maarten-pennings/6502/0intro/6502-4.png

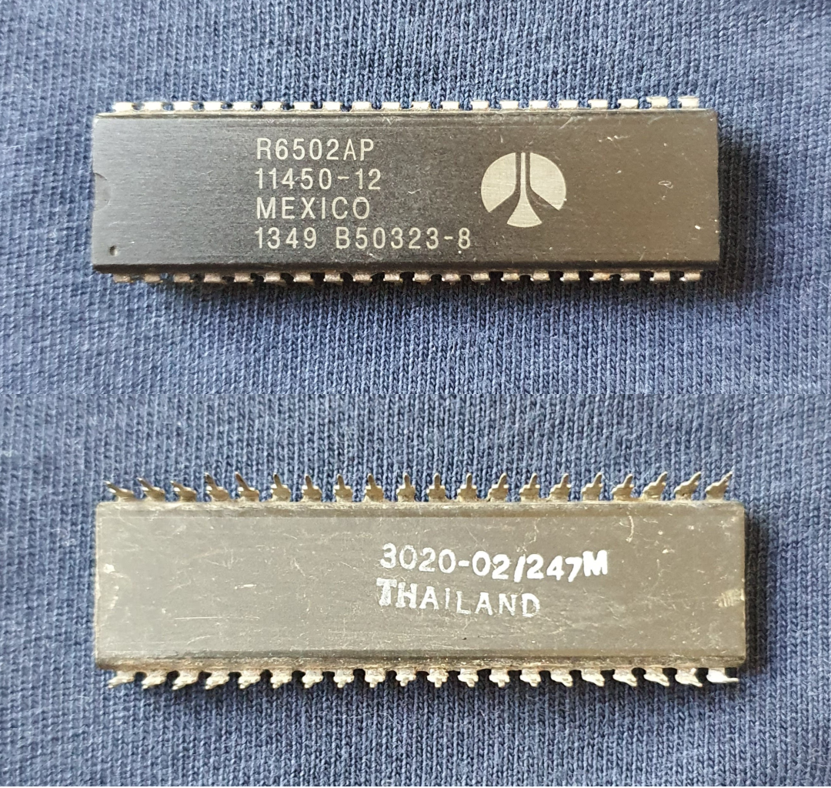
0intro/6502-4.png
