maarten-pennings/6502/1clock/unicode-chrome-windows-edit.png

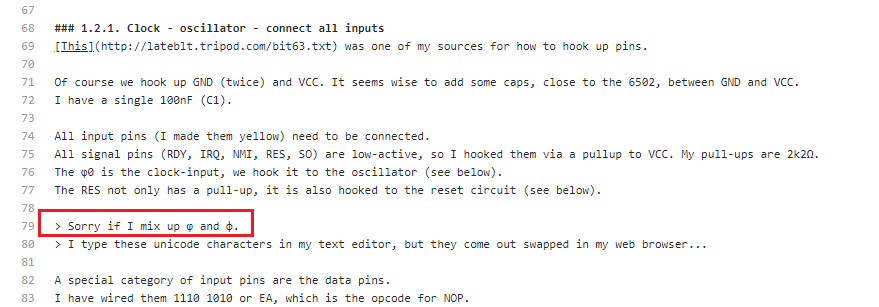
1clock/unicode-chrome-windows-edit.png
