maarten-pennings/6502/1clock/unicode-chrome-windows-view.png

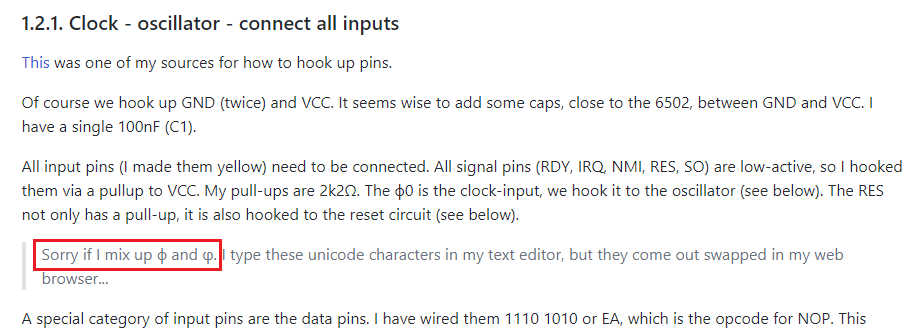
1clock/unicode-chrome-windows-view.png
