maarten-pennings/6502/2emulation/2560shield.pdf

Address bus | R65C02 (slave)

## Output signals

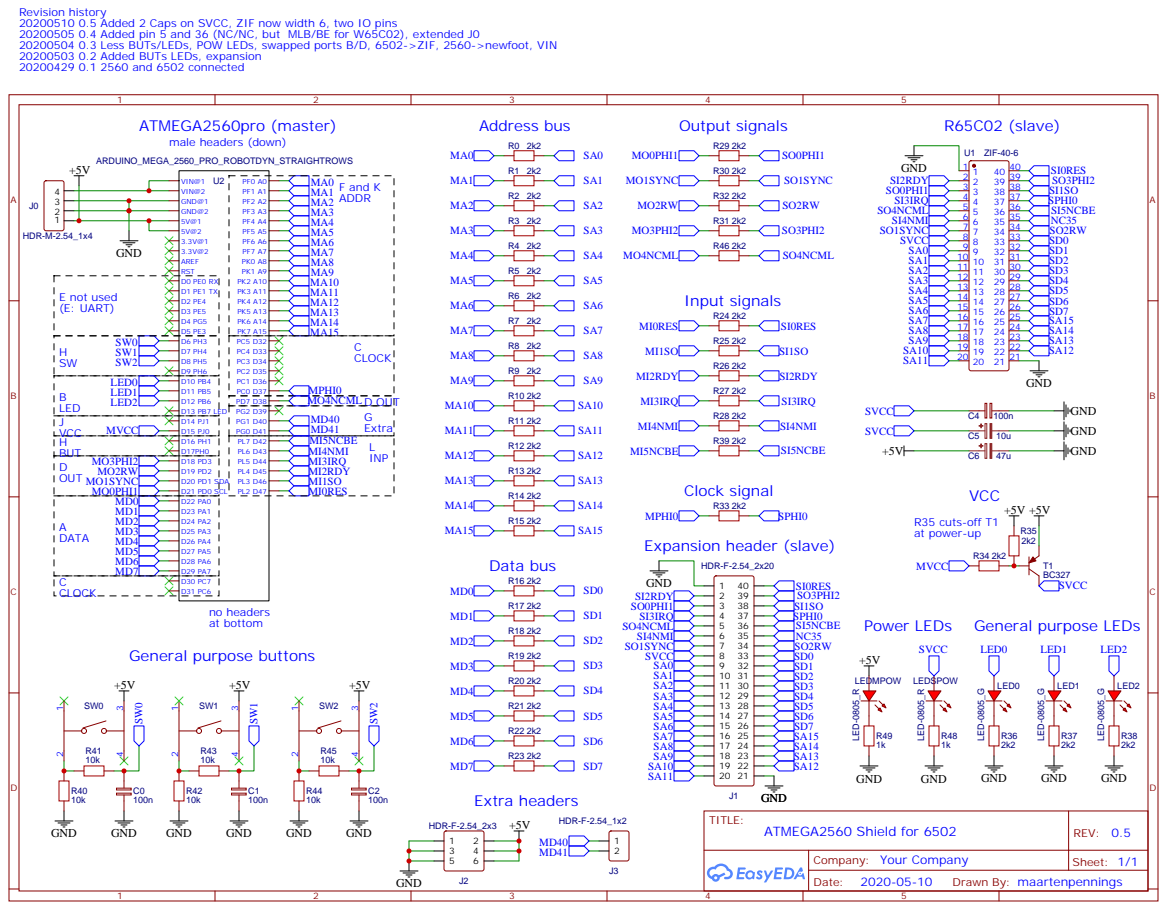
[picture p95: page 1]

Revision history
20200510 0.5 Added 2 Caps on SVCC, ZIF now width 6, two IO pins
20200505 0.4 Added pin 5 and 36 (NC/NC, but MLB/BE for W65C02), extended J0
20200504 0.3 Less BUTs/LEDs, POW LEDs, swapped ports B/D, 6502->ZIF, 2560->newfoot, VIN
20200503 0.2 Added BUTs LEDs, expansion
20200429 0.1 2560 and 6502 connected
