maarten-pennings/6502/3eeprom/eeprom-programmer_schema.pdf

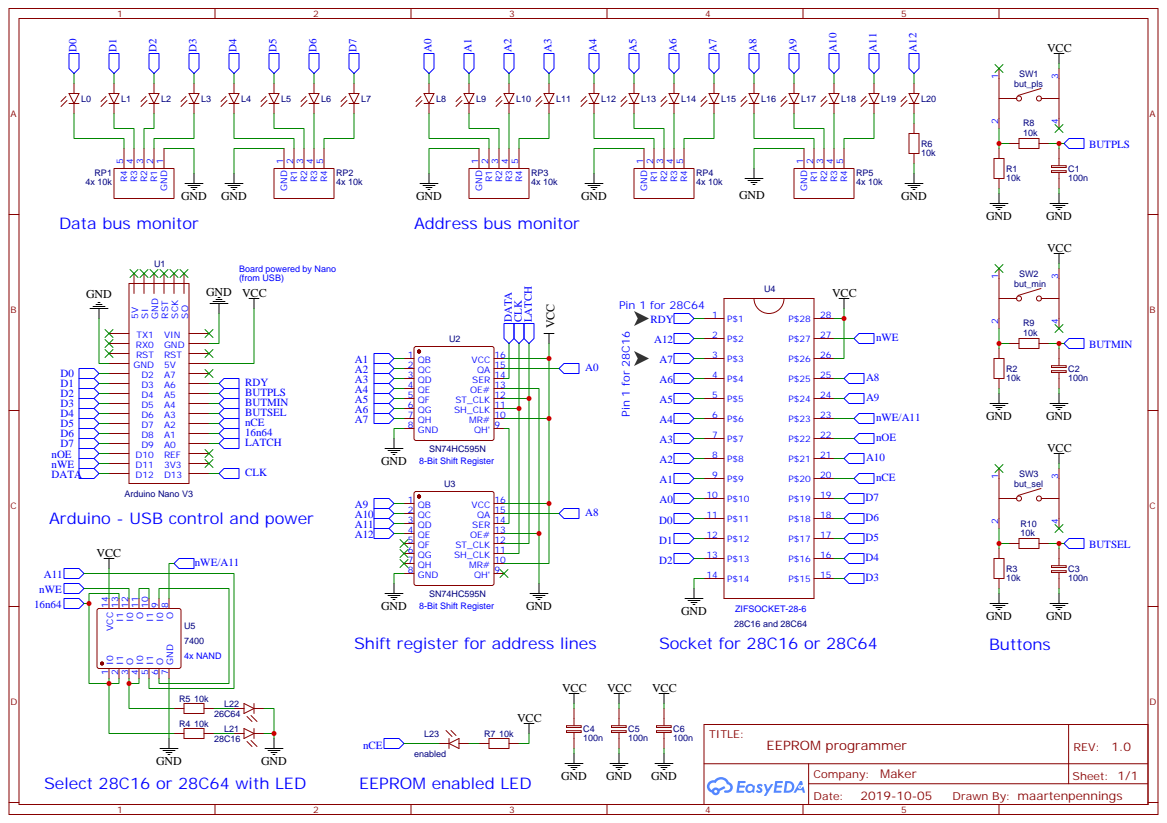
[picture p96: page 1]

Board powered by Nano
(from USB)

MR# 10 SH_CLK 11 ST_CLK 12 OE# 13 SER 14 QA 15 VCC 16

Arduino - USB control and power

GND
Shift register for address lines

Select 28C16 or 28C64 with LED
