maarten-pennings/6502/1clock/clock3-schematic.pdf

## 3 AND

## 3 AND

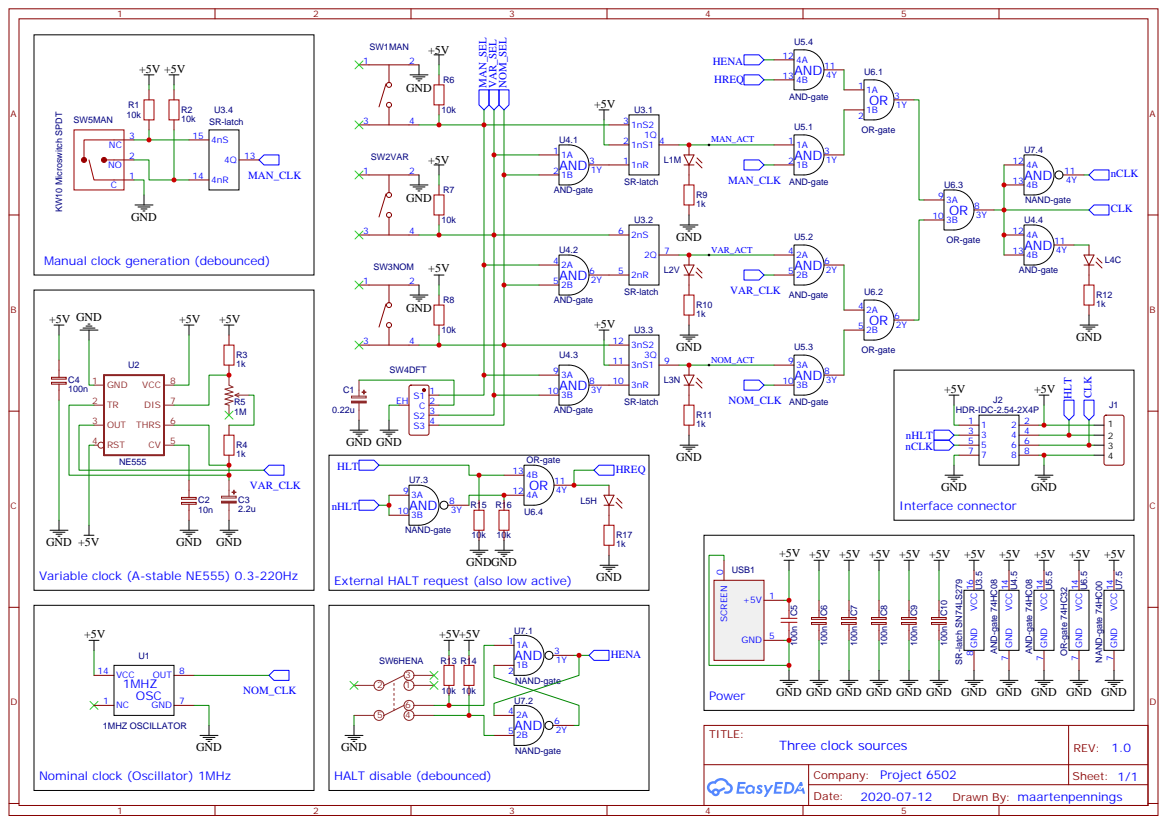
[picture p97: page 1]

Manual clock generation (debounced)

External HALT request (also low active)
