maarten-pennings/6502/(commit log)

2019-08-11 archive all schematics
2019-08-12 move of dirs doesn't work
    [clock6502.ino, clockvar6502.ino]
2019-08-12 added sample script
2019-08-16 Added 5 Interrupt (IRQ)
2019-08-24 Write and wiring
2019-08-25 schematic ram+eeprom
2019-08-25 added LEDs
2019-08-25 Added board photos
2019-08-29 inserted 5decoder
2019-08-30 to gnd
2019-09-07 Arduino eeprom programmer now polls for write to complete (and verify prints program time)
2019-09-07 Added support for 74HC595 Added power-on LED animation
2019-09-07 Arduino programmer V2
2019-09-08 Added uart overflow detection
2019-09-08 added 7-segment-driver.png
2019-09-10 wire fix
2019-09-12 added trace
2019-10-14 - added support for AT28C64 - added support for chip-enable - added select button to speed up address stepping
2019-11-10 Buttons select type/enable Removed warnings
2019-11-10 led 3D
2020-04-26 Slow clock circuits
2020-07-12 Added clock pcb
2020-07-29 added pcb
2020-07-29 clk pcb
2020-09-07 NE555 timing
    [ne555.xlsx]
2025-01-22 JMP addr typos in the trace annotation for Mega
